StephenArwine/SaLElectronics/hw/SaL_Frostburn-v1.1/pdf's/SaLFrostburnbrd.pdf

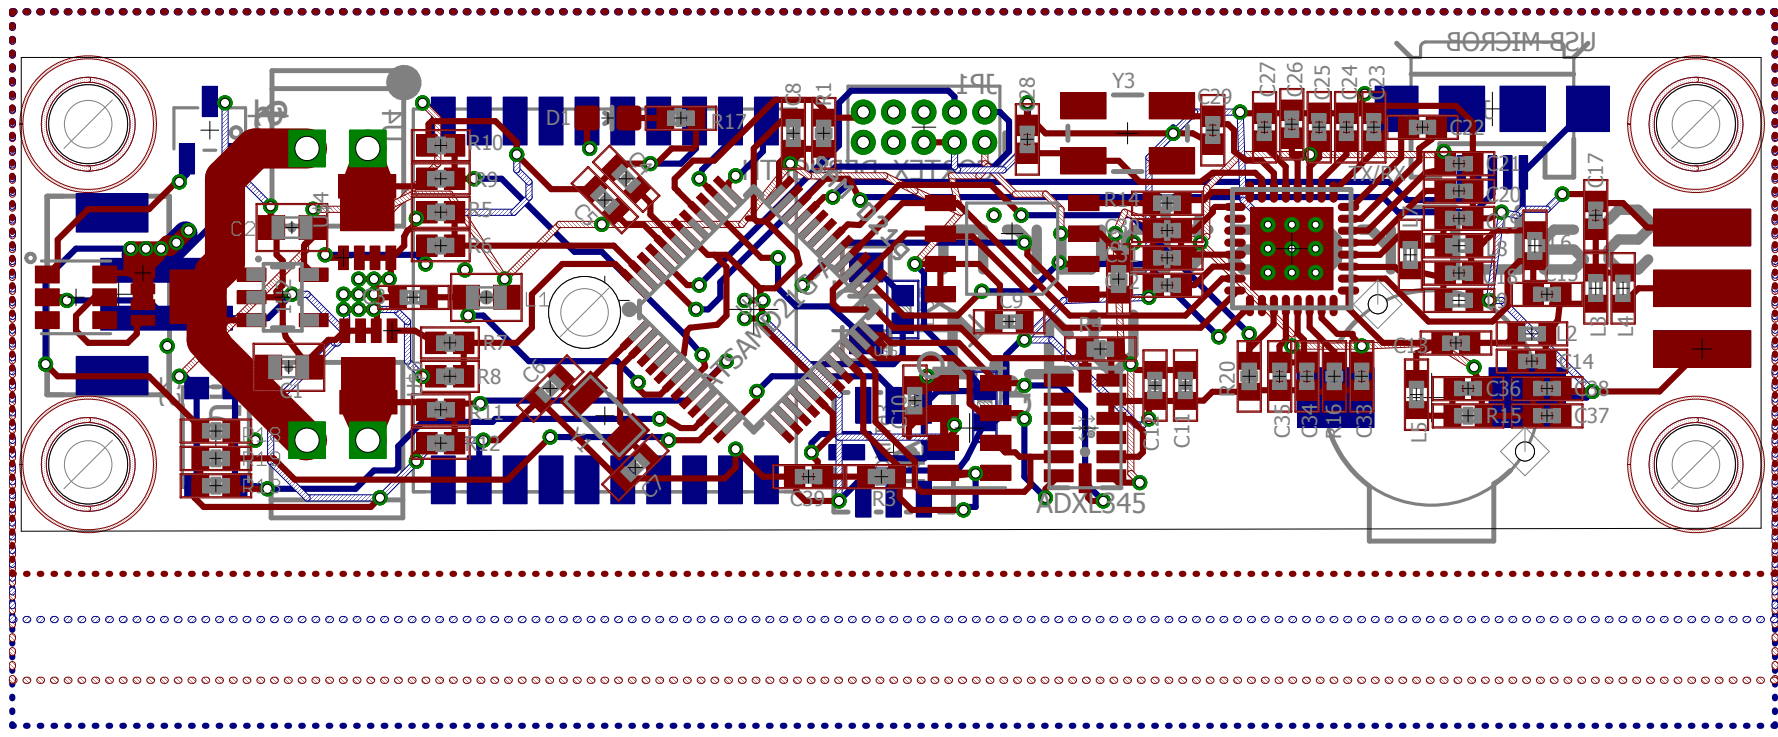
[picture p3: page 1]
