StephenArwine/SaLElectronics/hw/SaL_GPSTrack/SaL_GPSTrack.brd

## EAGLE design hw/SaL_GPSTrack/SaL_GPSTrack.brd (2017-10-22)

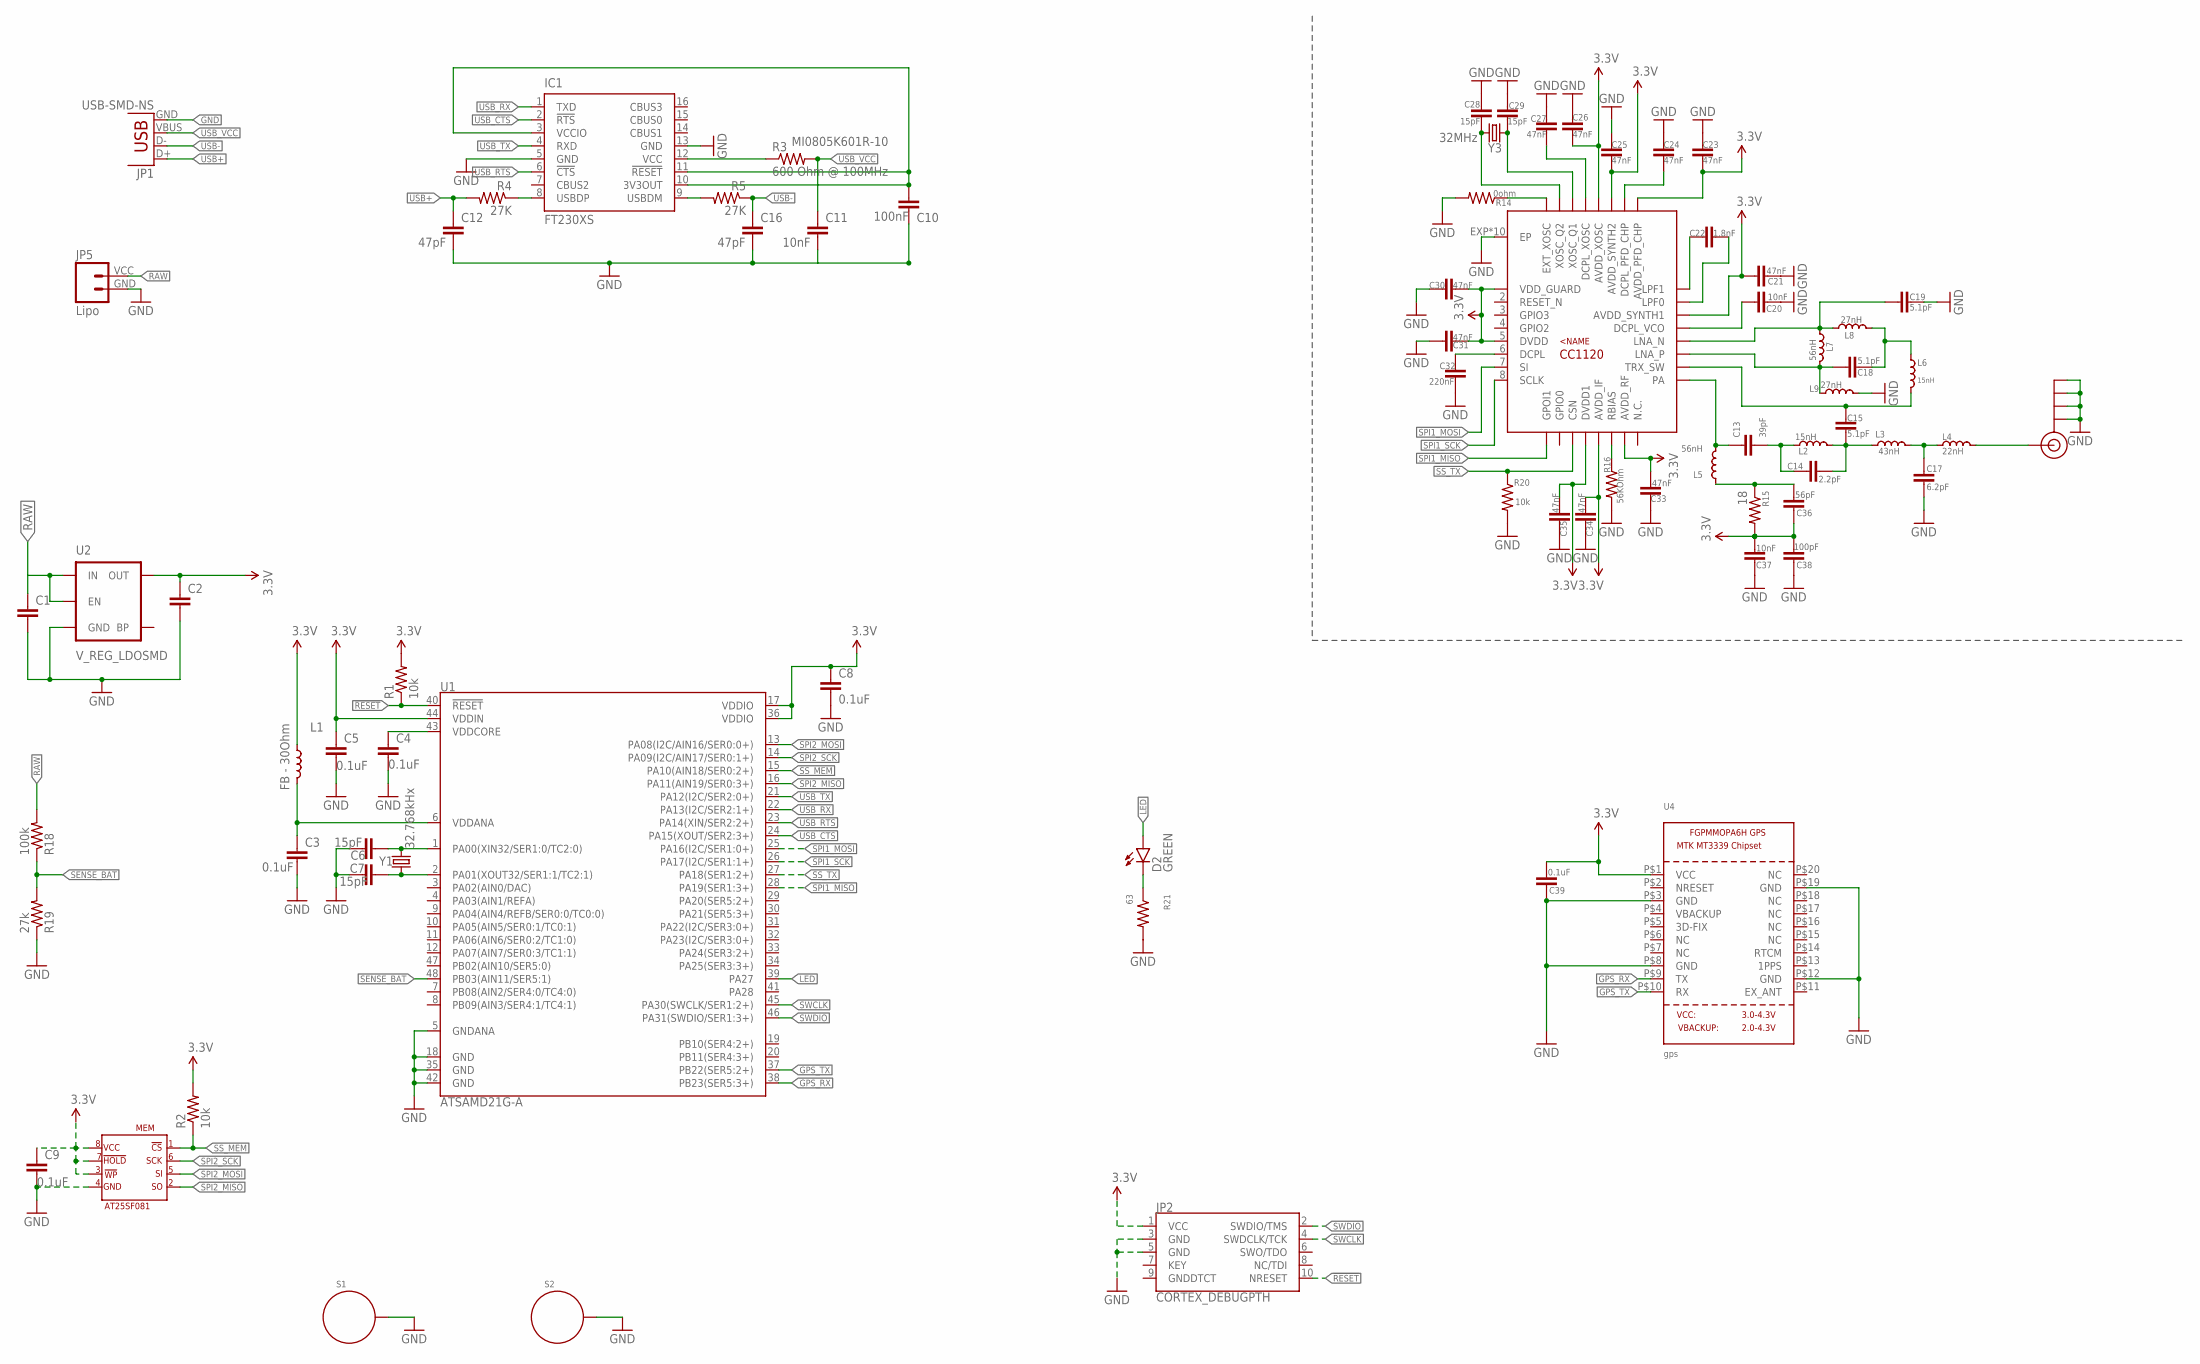
[picture p4: schematic SaL_GPSTrack.sch]

Parts:
C1, C2: CAP0603-CAP; 0603-CAP
C3, C4, C5, C8, C9, C39: 0.1uF; 0402-CAP
C6, C7, C28, C29: 15pF; 0402-CAP
C10: 100nF; 0402-CAP
C11, C20, C37: 10nF; 0402-CAP
C12, C16: 47pF; 0402-CAP
C13: 39pF; 0402-CAP
C14: 2.2pF; 0402-CAP
C15, C18, C19: 5.1pF; 0402-CAP
C17: 6.2pF; 0402-CAP
C21, C23, C24, C25, C26, C27, C30, C31, C33, C34, C35: 47nF; 0402-CAP
C22: 1.8nF; 0402-CAP
C32: 220nF; 0402-CAP
C36: 56pF; 0402-CAP
C38: 100pF; 0402-CAP
D2: GREEN; LED-1206
IC1: FT230XS; SSOP16
J$1: SMA_EDGE; SMA-EDGE
JP1: USB-SMD-NS; USB-MINIB-NOSTOP
JP2: CORTEX_DEBUGPTH; 2X5-PTH-1.27MM
JP5: Lipo; JST-2-SMD-VERT
L1: FB - 30Ohm; 0603
L2, L6: 15nH; C0402
L3: 43nH; C0402
L4: 22nH; C0402
L5, L7: 56nH; C0402
L8, L9: 27nH; C0402
MEM: AT25SF081
R1, R2, R20: 10k; 0402-RES
R3: 600 Ohm @ 100MHz; 0603-RES
R4, R5: 27K; 0402-RES
R14: 0ohm; 0402-RES
R15: 18; 0402-RES
R16: 56KOhm; 0402-RES
R18: 100k; 0402-RES
R19: 27k; 0402-RES
R21: 63; 0402-RES
S1, S2: STANDOFF_ELECTRICAL; STANDOFF-ELECTRICAL
TX/RX: CC1120
U1: ATSAMD21G-A; TQFP-48
U2: V_REG_LDOSMD; SOT23-5
U4: gps; FGPMMOPA6H
Y1: 32.768kHx; CRYSTAL-SMD-3.2X1.5MM
Y3: 32MHz; CRYSTAL-SMD-5X3

Connections:
!RESET: JP2.10 (NRESET), R1.1, U1.40 (!RESET!)
+3.3V: C2.1, C5.1, C8.1, C9.1, C21.1, C23.2, C25.2, C26.2, C30.2, C31.2, C33.2, C34.2, C35.2, C36.1, C37.2, C38.2, C39.2, JP2.1 (VCC), L1.1, MEM.!HOLD, MEM.!WP, MEM.VCC, R1.2, R2.2, R15.2, TX/RX.1 (VDD_GUARD), TX/RX.5 (DVDD), TX/RX.12 (DVDD1), TX/RX.13 (AVDD_IF), TX/RX.15 (AVDD_RF), TX/RX.22 (AVDD_SYNTH1), TX/RX.25 (AVDD_PFD_CHP), TX/RX.27 (AVDD_SYNTH2), TX/RX.28 (AVDD_XOSC), U1.17 (VDDIO), U1.36 (VDDIO), U1.44 (VDDIN), U2.5 (OUT), U4.P$1 (VCC)
GND: C1.2, C2.2, C3.2, C4.2, C5.2, C6.2, C7.2, C8.2, C9.2, C10.2, C11.2, C12.2, C16.2, C17.2, C19.2, C20.2, C21.2, C23.1, C24.1, C25.1, C26.1, C27.1, C28.1, C29.1, C30.1, C31.1, C32.1, C33.1, C34.1, C35.1, C37.1, C38.1, C39.1, IC1.5 (GND), IC1.13 (GND), J$1.GND@0 (GND), J$1.GND@1 (GND), J$1.GND@2 (GND), J$1.GND@3 (GND), JP1.GND, JP2.3 (GND), JP2.5 (GND), JP5.GND (1), L9.2, MEM.GND, R14.2, R16.2, R19.1, R20.2, R21.2, S1.P1, S2.P1, TX/RX.EXP (EP), TX/RX.EXP@1 (EP), TX/RX.EXP@2 (EP), TX/RX.EXP@3 (EP), TX/RX.EXP@4 (EP), TX/RX.EXP@5 (EP), TX/RX.EXP@6 (EP), TX/RX.EXP@7 (EP), TX/RX.EXP@8 (EP), TX/RX.EXP@9 (EP), U1.5 (GNDANA), U1.18 (GND), U1.35 (GND), U1.42 (GND), U2.2 (GND), U4.P$3 (GND), U4.P$8 (GND), U4.P$12 (GND), U4.P$19 (GND)
GPS_RX: U1.38 (PB23(SER5:3+)), U4.P$9 (TX)
GPS_TX: U1.37 (PB22(SER5:2+)), U4.P$10 (RX)
LED: D2.A, U1.39 (PA27)
unnamed: IC1.12 (VCC), R3.1
unnamed: C6.1, U1.1 (PA00(XIN32/SER1:0/TC2:0)), Y1.P$2 (2)
unnamed: C7.1, U1.2 (PA01(XOUT32/SER1:1/TC2:1)), Y1.P$1 (1)
unnamed: C3.1, L1.2, U1.6 (VDDANA)
unnamed: C4.1, U1.43 (VDDCORE)
unnamed: C10.1, IC1.3 (VCCIO), IC1.10 (3V3OUT), IC1.11 (!RESET)
unnamed: IC1.8 (USBDP), R4.1
unnamed: C13.1, L5.2, TX/RX.17 (PA)
unnamed: C13.2, C14.1, L2.1
unnamed: C14.2, C15.1, L2.2, L3.1
unnamed: C17.1, L3.2, L4.1
unnamed: J$1.SIG (SIGNAL), L4.2
unnamed: IC1.9 (USBDM), R5.2
unnamed: C15.2, L6.2, TX/RX.18 (TRX_SW)
unnamed: C18.1, L7.2, L9.1, TX/RX.19 (LNA_P)
unnamed: C18.2, L6.1, L8.2
unnamed: C19.1, L7.1, L8.1, TX/RX.20 (LNA_N)
unnamed: C22.1, TX/RX.24 (LPF1)
unnamed: C22.2, TX/RX.23 (LPF0)
unnamed: C20.1, TX/RX.21 (DCPL_VCO)
unnamed: C24.2, TX/RX.26 (DCPL_PFD_CHP)
unnamed: R16.1, TX/RX.14 (RBIAS)
unnamed: R14.1, TX/RX.32 (EXT_XOSC)
unnamed: C27.2, TX/RX.29 (DCPL_XOSC)
unnamed: C29.2, TX/RX.30 (XOSC_Q1), Y3.3 (2)
unnamed: C28.2, TX/RX.31 (XOSC_Q2), Y3.1
unnamed: D2.C, R21.1
unnamed: C32.2, TX/RX.6 (DCPL)
unnamed: C36.2, L5.1, R15.1
RAW: C1.1, JP5.VCC (2), R18.2, U2.1 (IN), U2.3 (EN)
SENSE_BAT: R18.1, R19.2, U1.48 (PB03(AIN11/SER5:1))
SPI1_MISO: TX/RX.9 (GPOI1), U1.28 (PA19(SER1:3+))
SPI1_MOSI: TX/RX.7 (SI), U1.25 (PA16(I2C/SER1:0+))
SPI1_SCK: TX/RX.8 (SCLK), U1.26 (PA17(I2C/SER1:1+))
SPI2_MISO: MEM.SO, U1.16 (PA11(AIN19/SER0:3+))
SPI2_MOSI: MEM.SI, U1.13 (PA08(I2C/AIN16/SER0:0+))
SPI2_SCK: MEM.SCK, U1.14 (PA09(I2C/AIN17/SER0:1+))
SS_MEM: MEM.!CS, R2.1, U1.15 (PA10(AIN18/SER0:2+))
SS_TX: R20.1, TX/RX.11 (CSN), U1.27 (PA18(SER1:2+))
SWCLK: JP2.4 (SWDCLK/TCK), U1.45 (PA30(SWCLK/SER1:2+))
SWDIO: JP2.2 (SWDIO/TMS), U1.46 (PA31(SWDIO/SER1:3+))
USB+: C12.1, JP1.D+, R4.2
USB-: C16.1, JP1.D-, R5.1
USB_CTS: IC1.2 (!RTS), U1.24 (PA15(XOUT/SER2:3+))
USB_RTS: IC1.6 (!CTS), U1.23 (PA14(XIN/SER2:2+))
USB_RX: IC1.1 (TXD), U1.22 (PA13(I2C/SER2:1+))
USB_TX: IC1.4 (RXD), U1.21 (PA12(I2C/SER2:0+))
USB_VCC: C11.1, JP1.VBUS, R3.2

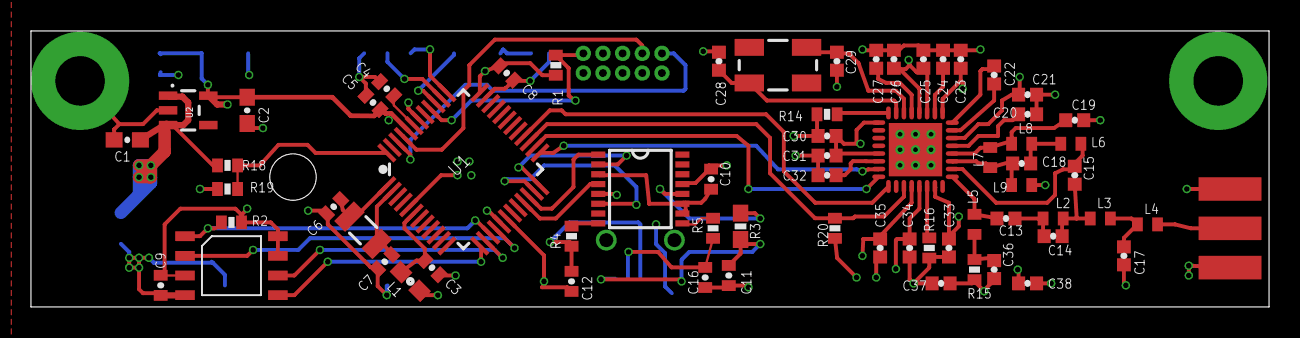
[picture p5: board SaL_GPSTrack.brd from above]

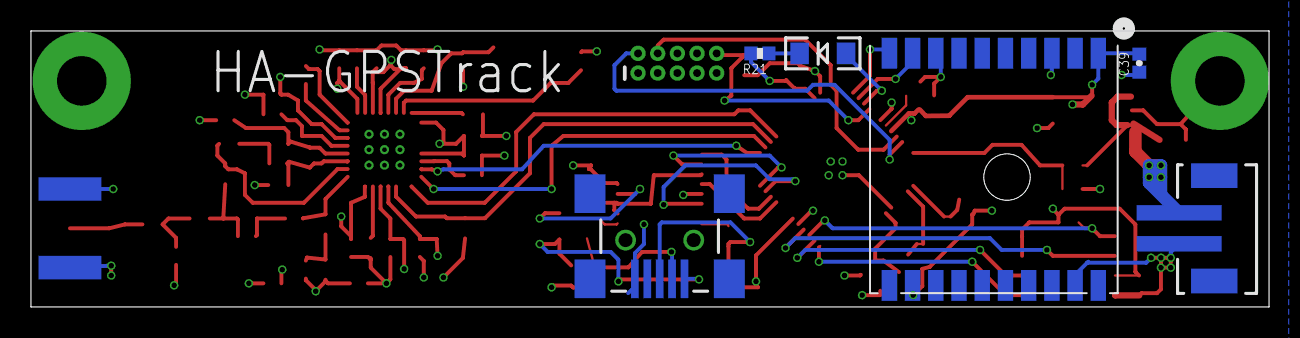
[picture p6: board SaL_GPSTrack.brd from below]

Board: 4 copper layers, 80.0 x 17.8 mm, 75 parts (7 on the bottom side), 54 nets.
