StephenArwine/SaLElectronics/hw/SaLAltimeter/SaLAltimeter.brd

## EAGLE design hw/SaLAltimeter/SaLAltimeter.brd (2016-01-22)

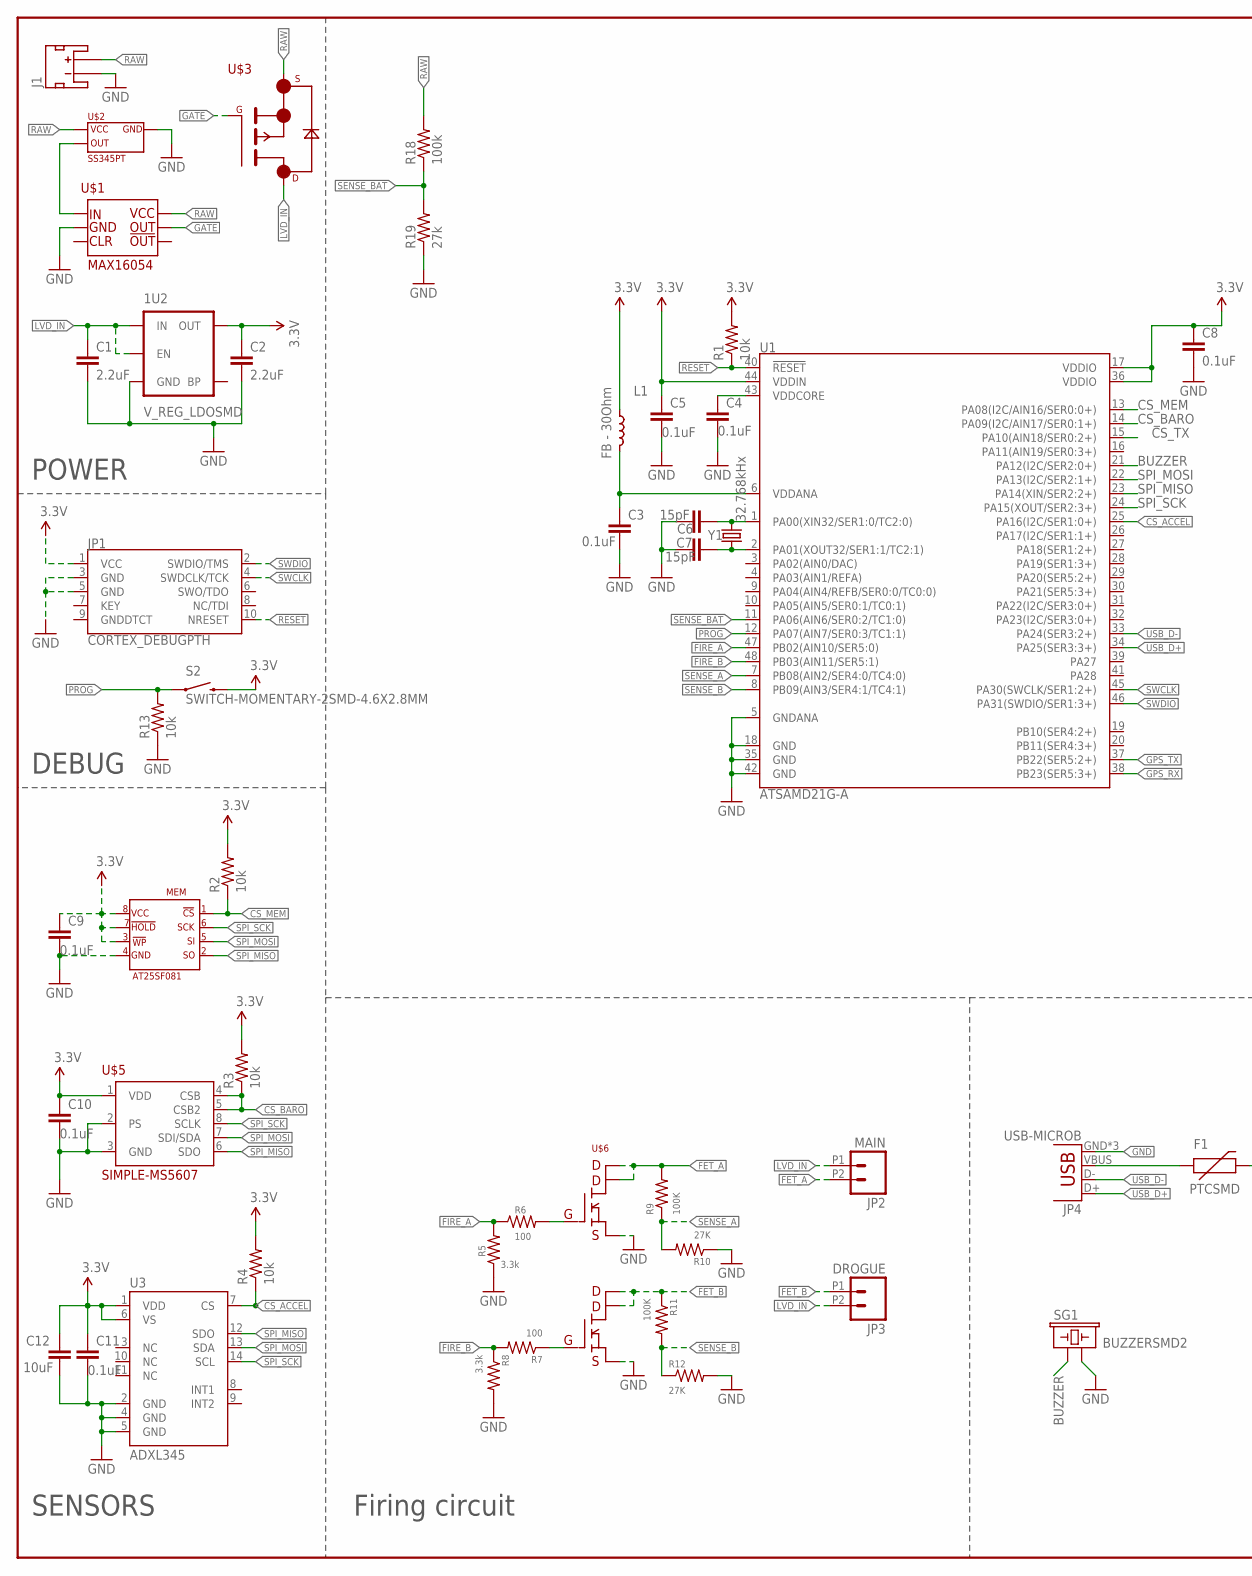
[picture p7: schematic SaLAltimeter.sch, part in row 1, column 1]

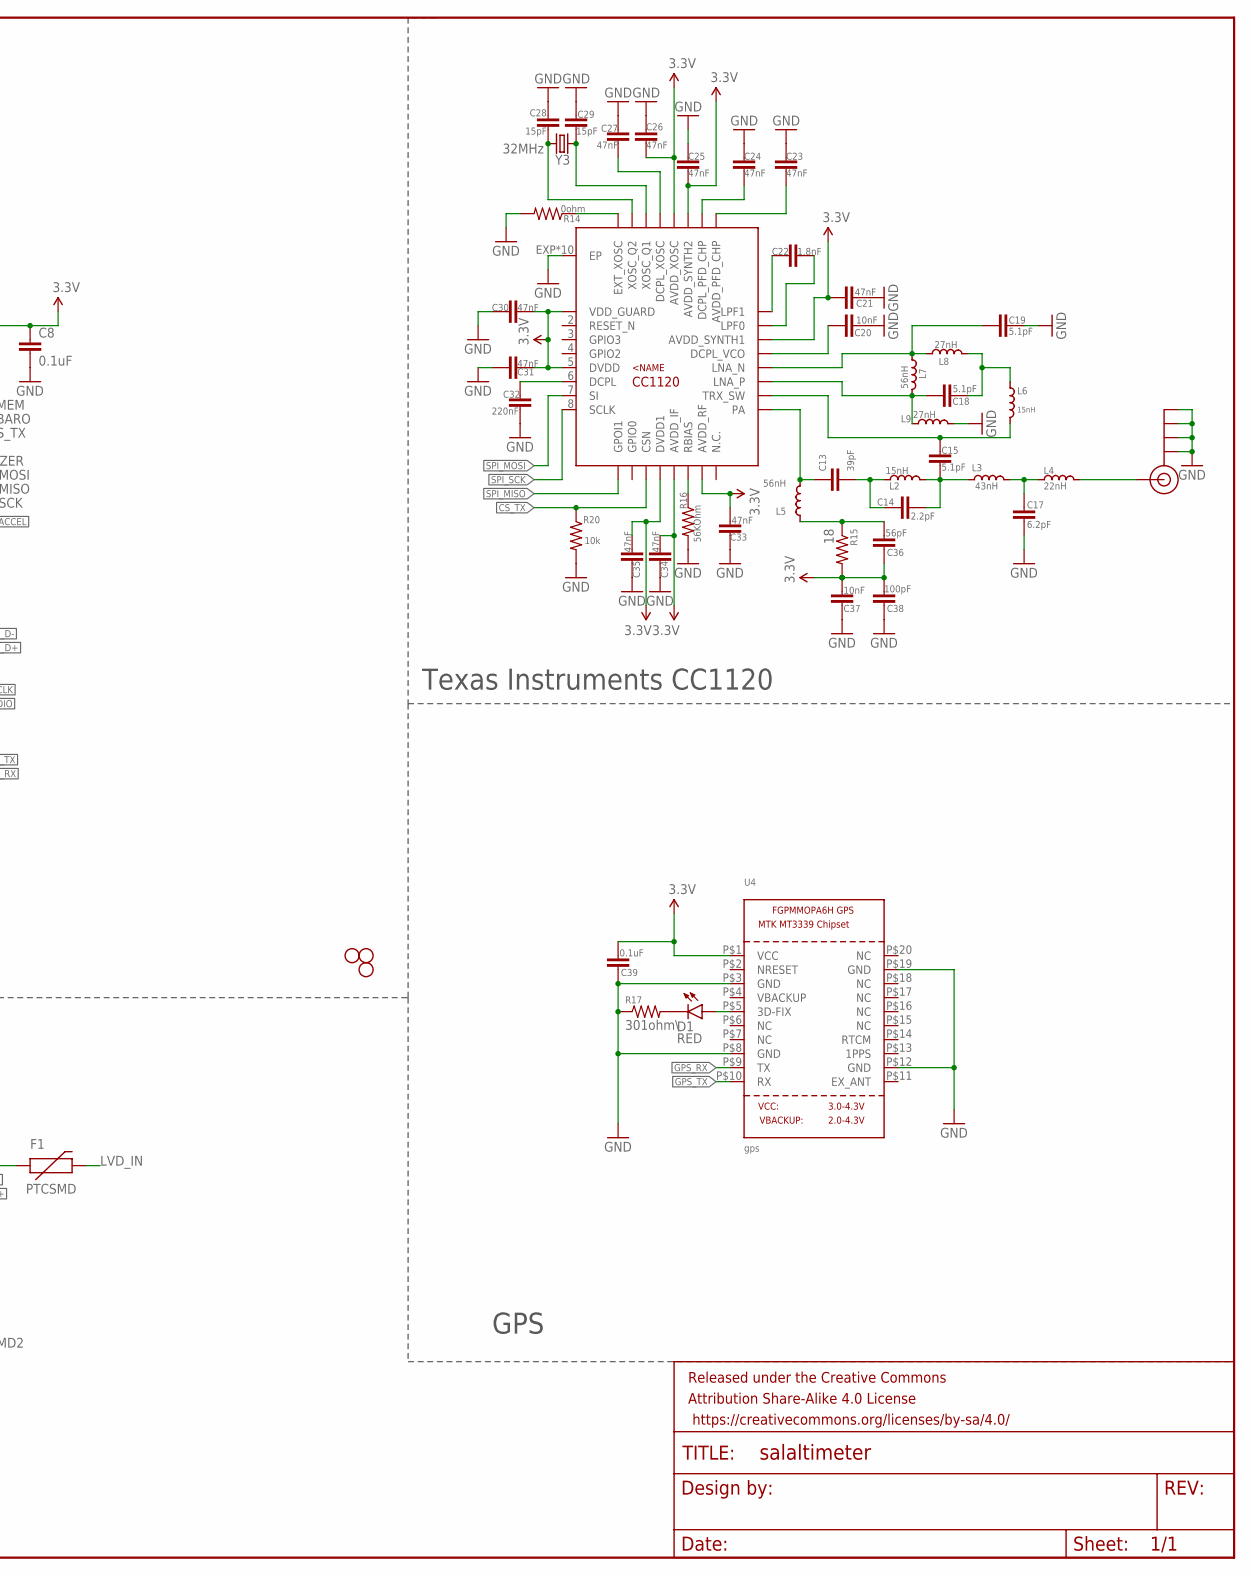
[picture p8: schematic SaLAltimeter.sch, part in row 1, column 2]

Parts:
1U2: V_REG_LDOSMD; SOT23-5
C1, C2: 2.2uF; 0603-CAP
C3, C4, C5, C8, C9, C10, C11, C39: 0.1uF; 0402-CAP
C6, C7, C28, C29: 15pF; 0402-CAP
C12: 10uF; 0402-CAP
C13: 39pF; 0402-CAP
C14: 2.2pF; 0402-CAP
C15, C18, C19: 5.1pF; 0402-CAP
C17: 6.2pF; 0402-CAP
C20, C37: 10nF; 0402-CAP
C21, C23, C24, C25, C26, C27, C30, C31, C33, C34, C35: 47nF; 0402-CAP
C22: 1.8nF; 0402-CAP
C32: 220nF; 0402-CAP
C36: 56pF; 0402-CAP
C38: 100pF; 0402-CAP
D1: RED; LED-0603
F1: PTCSMD; PTC-1206
FRAME1: FRAME-LEDGER; CREATIVE_COMMONS
J1: BAT; JST-2-SMD
J$1: SMA_EDGE; SMA-EDGE
JP1: CORTEX_DEBUGPTH; 2X5-PTH-1.27MM
JP2: MAIN; 1X02_2.54_SCREWTERM
JP3: DROGUE; 1X02_2.54_SCREWTERM
JP4: USB-MICROB
L1: FB - 30Ohm; 0603
L2, L6: 15nH; C0402
L3: 43nH; C0402
L4: 22nH; C0402
L5, L7: 56nH; C0402
L8, L9: 27nH; C0402
MEM: AT25SF081
R1, R2, R3, R4, R13, R20: 10k; 0402-RES
R5, R8: 3.3k; 0402-RES
R6, R7: 100; 0402-RES
R9, R11: 100K; 0402-RES
R10, R12: 27K; 0402-RES
R14: 0ohm; 0402-RES
R15: 18; 0402-RES
R16: 56KOhm; 0402-RES
R17: 301ohm\; 0402-RES
R18: 100k; 0402-RES
R19: 27k; 0402-RES
S2: SWITCH-MOMENTARY-2SMD-4.6X2.8MM; TACTILE_SWITCH_SMD_4.6X2.8MM
SG1: BUZZERSMD2; BUZZER-CCV
STANDOFF1, STANDOFF2, STANDOFF3: STAND-OFF
U1: ATSAMD21G-A; TQFP-48
U2: CC1120
U3: ADXL345; LGA14
U4: gps; FGPMMOPA6H
U$1: MAX16054
U$2: SS345PT
U$3: SI7615ADN
U$5: SIMPLE-MS5607; MS5607
U$6: SI7232DN
Y1: 32.768kHx; CRYSTAL-SMD-3.2X1.5MM
Y3: 32MHz; CRYSTAL-SMD-5X3

Connections:
3.3V: 1U2.5 (OUT), C2.1, C5.1, C8.1, C9.1, C10.1, C11.1, C12.1, C21.1, C25.2, C26.2, C30.2, C31.2, C33.2, C34.2, C35.2, C36.1, C37.2, C38.2, C39.2, JP1.1 (VCC), L1.1, MEM.!HOLD, MEM.!WP, MEM.VCC, R1.2, R2.2, R3.2, R4.2, R15.2, S2.3 (2), S2.4 (2), U1.17 (VDDIO), U1.36 (VDDIO), U1.44 (VDDIN), U2.1 (VDD_GUARD), U2.5 (DVDD), U2.12 (DVDD1), U2.13 (AVDD_IF), U2.15 (AVDD_RF), U2.22 (AVDD_SYNTH1), U2.27 (AVDD_SYNTH2), U2.28 (AVDD_XOSC), U3.1 (VDD), U3.6 (VS), U4.P$1 (VCC), U$5.1 (VDD)
!RESET: JP1.10 (NRESET), R1.1, U1.40 (!RESET!)
BUZZER: SG1.+ (1), U1.21 (PA12(I2C/SER2:0+))
CS_ACCEL: R4.1, U1.25 (PA16(I2C/SER1:0+)), U3.7 (CS)
CS_BARO: R3.1, U1.14 (PA09(I2C/AIN17/SER0:1+)), U$5.4 (CSB), U$5.5 (CSB2)
CS_MEM: MEM.!CS, R2.1, U1.13 (PA08(I2C/AIN16/SER0:0+))
CS_TX: R20.1, U1.15 (PA10(AIN18/SER0:2+)), U2.11 (CSN)
FET_A: JP2.P2 (2), R9.2, U$6.7 (PIN7), U$6.8 (PIN8)
FET_B: JP3.P1 (1), R11.1, U$6.5 (PIN5), U$6.6 (PIN6)
FIRE_A: R5.2, R6.1, U1.47 (PB02(AIN10/SER5:0))
FIRE_B: R7.2, R8.1, U1.48 (PB03(AIN11/SER5:1))
GATE: U$1.OUT, U$3.G
GND: 1U2.2 (GND), C1.2, C2.2, C3.2, C4.2, C5.2, C6.2, C7.2, C8.2, C9.2, C10.2, C11.2, C12.2, C17.2, C19.2, C20.2, C21.2, C23.1, C24.1, C25.1, C26.1, C27.1, C28.1, C29.1, C30.1, C31.1, C32.1, C33.1, C34.1, C35.1, C37.1, C38.1, C39.1, J1.1 (-), J$1.GND@0 (GND), J$1.GND@1 (GND), J$1.GND@2 (GND), J$1.GND@3 (GND), JP1.3 (GND), JP1.5 (GND), JP4.GND, JP4.MT1 (GND), JP4.MT2 (GND), L9.2, MEM.GND, R5.1, R8.2, R10.1, R12.2, R13.1, R14.2, R16.2, R17.1, R19.1, R20.2, SG1.- (2), U1.5 (GNDANA), U1.18 (GND), U1.35 (GND), U1.42 (GND), U2.EXP (EP), U2.EXP@1 (EP), U2.EXP@2 (EP), U2.EXP@3 (EP), U2.EXP@4 (EP), U2.EXP@5 (EP), U2.EXP@6 (EP), U2.EXP@7 (EP), U2.EXP@8 (EP), U2.EXP@9 (EP), U3.2 (GND), U3.4 (GND), U3.5 (GND), U4.P$3 (GND), U4.P$8 (GND), U4.P$12 (GND), U4.P$19 (GND), U$1.GND, U$2.GND, U$5.2 (PS), U$5.3 (GND), U$6.1 (PIN1), U$6.3 (PIN3)
GPS_RX: U1.38 (PB23(SER5:3+)), U4.P$9 (TX)
GPS_TX: U1.37 (PB22(SER5:2+)), U4.P$10 (RX)
LVD_IN: 1U2.1 (IN), 1U2.3 (EN), C1.1, F1.2, JP2.P1 (1), JP3.P2 (2), U$3.D1 (D), U$3.D2 (D), U$3.D3 (D), U$3.D4 (D)
unnamed: R6.2, U$6.2 (PIN2)
unnamed: U$1.IN, U$2.OUT
unnamed: C6.1, U1.1 (PA00(XIN32/SER1:0/TC2:0)), Y1.P$2 (2)
unnamed: C7.1, U1.2 (PA01(XOUT32/SER1:1/TC2:1)), Y1.P$1 (1)
unnamed: C3.1, L1.2, U1.6 (VDDANA)
unnamed: C4.1, U1.43 (VDDCORE)
unnamed: R7.1, U$6.4 (PIN4)
unnamed: C13.1, L5.2, U2.17 (PA)
unnamed: C13.2, C14.1, L2.1
unnamed: C14.2, C15.1, L2.2, L3.1
unnamed: C17.1, L3.2, L4.1
unnamed: J$1.SIG (SIGNAL), L4.2
unnamed: F1.1, JP4.VBUS
unnamed: C23.2, U2.25 (AVDD_PFD_CHP)
unnamed: C15.2, L6.2, U2.18 (TRX_SW)
unnamed: C18.1, L7.2, L9.1, U2.19 (LNA_P)
unnamed: C18.2, L6.1, L8.2
unnamed: C19.1, L7.1, L8.1, U2.20 (LNA_N)
unnamed: C22.1, U2.24 (LPF1)
unnamed: C22.2, U2.23 (LPF0)
unnamed: C20.1, U2.21 (DCPL_VCO)
unnamed: C24.2, U2.26 (DCPL_PFD_CHP)
unnamed: R16.1, U2.14 (RBIAS)
unnamed: R14.1, U2.32 (EXT_XOSC)
unnamed: C27.2, U2.29 (DCPL_XOSC)
unnamed: C29.2, U2.30 (XOSC_Q1), Y3.3 (2)
unnamed: C28.2, U2.31 (XOSC_Q2), Y3.1
unnamed: D1.C, R17.2
unnamed: D1.A, U4.P$5 (3D-FIX)
unnamed: C32.2, U2.6 (DCPL)
unnamed: C36.2, L5.1, R15.1
PROG: R13.2, S2.1, S2.2 (1), U1.12 (PA07(AIN7/SER0:3/TC1:1))
RAW: J1.2 (+), R18.2, U$1.VCC, U$2.VCC, U$3.S1 (S), U$3.S2 (S), U$3.S3 (S)
SENSE_A: R9.1, R10.2, U1.7 (PB08(AIN2/SER4:0/TC4:0))
SENSE_B: R11.2, R12.1, U1.8 (PB09(AIN3/SER4:1/TC4:1))
SENSE_BAT: R18.1, R19.2, U1.11 (PA06(AIN6/SER0:2/TC1:0))
SPI_MISO: MEM.SO, U1.23 (PA14(XIN/SER2:2+)), U2.9 (GPOI1), U3.12 (SDO), U$5.6 (SDO)
SPI_MOSI: MEM.SI, U1.22 (PA13(I2C/SER2:1+)), U2.7 (SI), U3.13 (SDA), U$5.7 (SDI/SDA)
SPI_SCK: MEM.SCK, U1.24 (PA15(XOUT/SER2:3+)), U2.8 (SCLK), U3.14 (SCL), U$5.8 (SCLK)
SWCLK: JP1.4 (SWDCLK/TCK), U1.45 (PA30(SWCLK/SER1:2+))
SWDIO: JP1.2 (SWDIO/TMS), U1.46 (PA31(SWDIO/SER1:3+))
USB_D+: JP4.D+, U1.34 (PA25(SER3:3+))
USB_D-: JP4.D-, U1.33 (PA24(SER3:2+))

Notes on the sheet:
POWER
DEBUG
SENSORS
Texas Instruments CC1120
Firing circuit
GPS

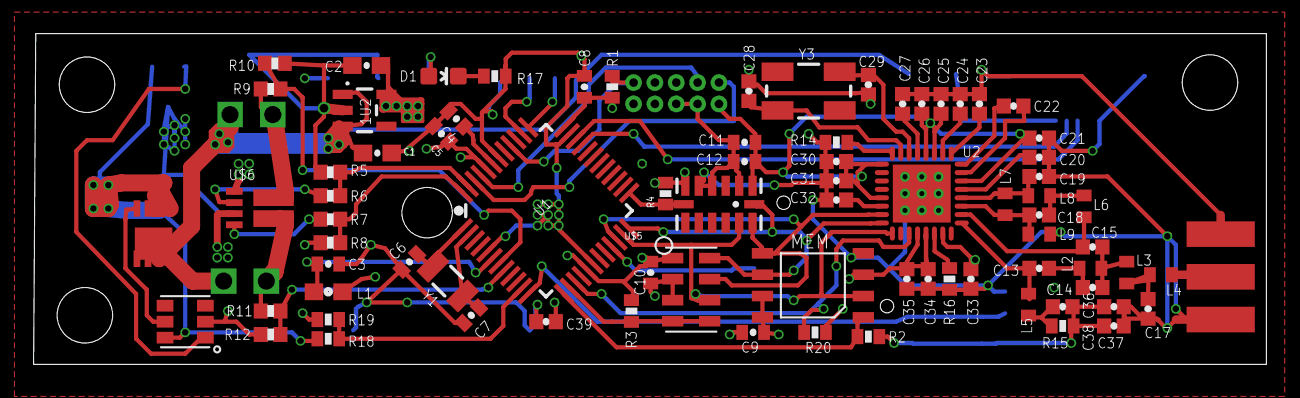
[picture p9: board SaLAltimeter.brd from above]

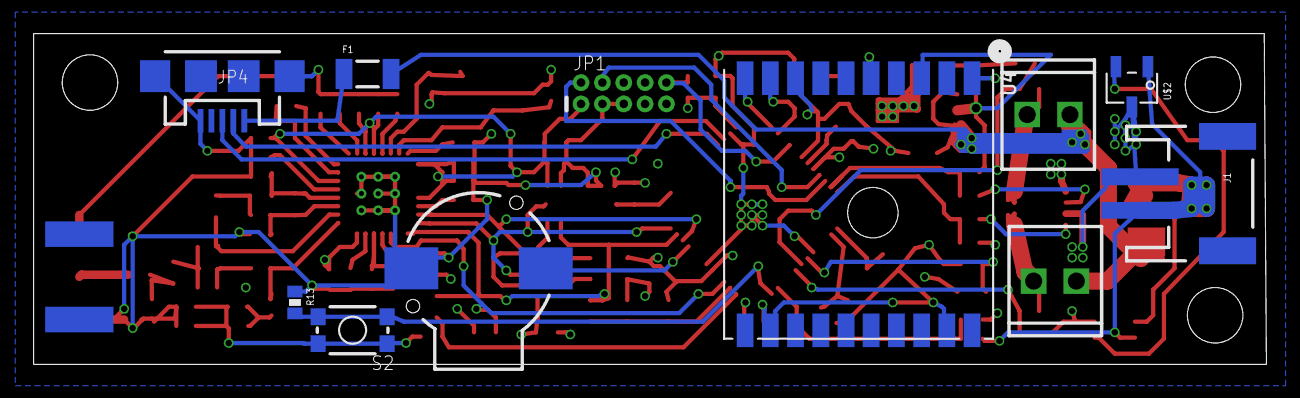
[picture p10: board SaLAltimeter.brd from below]

Board: 4 copper layers, 73.3 x 19.7 mm, 94 parts (11 on the bottom side), 59 nets.
