StephenArwine/SaLElectronics/src/services/SaL_flight.c

#include "SaL_flight.h"



void Sal_flight() {


    while (true) {

        switch (SaL_flight_state) {
        case SaL_flight_startup:
		
            break;

        case SaL_flight_pad:
		
            break;

        case  SaL_flight_boost:
		
            break;

        case SaL_flight_coast:
		
            break;

        case SaL_flight_drogue:
		
            break;

        case SaL_flight_main:
		
            break;

        case SaL_flight_landed:
		
            break;

        case  SaL_flight_error:
		
            break;

        case SaL_flight_program:
		
            break;

        default:
		
            break;
        }

    }

}

void SaL_flight_init() {

}
