StephenArwine/SaLElectronics/src/services/SaLTypes.h

#define ATOMIC_SECTION_ENTER   { register uint32_t __atomic; \
	__asm volatile ("mrs %0, primask" : "=r" (__atomic) ); \
	__asm volatile ("cpsid i");
#define ATOMIC_SECTION_LEAVE   __asm volatile ("msr primask, %0" : : "r" (__atomic) ); }

#include <stddef.h>
#include <stdint.h>
#include <stdio.h>
#include <stdlib.h>
#include <stdbool.h>
#include <string.h>
#include <compiler.h>
