StephenArwine/SaLElectronics/src/services/SaLSpi.h

#ifndef SALSPI_H_
#define SALSPI_H_

#include <SaL.h>
 
//   struct spiModule{
// 
//     uint8_t MISO;
// 
//     uint8_t MOSI;
// 
//     uint8_t SCK;
// 
//     uint8_t SS;
// 
//     uint8_t BYTEOUT;
// 
//     uint8_t BYTEIN;
// 
// #define PINHIGH true
// #define PINLOW false
// 
// };

//  void configSpiModule(struct spiModule *const module,
//                                    uint8_t MOSI_PIN,
//                                    uint8_t MISO_pin,
//                                    uint8_t SCK_PIN,
//                                    uint8_t SS_PIN );


#endif
