StephenArwine/SaLElectronics/(commit log)

2016-01-19 working on accelerometer crap
2016-01-20 finally fixed clocks and got others working woohoo
    [ADXL345.c, ADXL345.h, SaLBitBang.c, SaLBitBang.h, SaLBuzzer.c, SaLBuzzer.h, SaLDelay.c]
2016-01-22 got accelerometer working and working on v1.5 in eagle
    [SaLAltimeter 1.5.brd, SaLAltimeter 1.5.sch, SaLAltimeter.brd, SaLAltimeter.sch, partslist final.xlsx, partslist.xlsx, partslist2.xlsx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]
2016-01-23 fixed acceleration and bit banging using defines instead of spimodule struct
    [ADXL345.c, ADXL345.h, MS5607.c, MS5607.h, SaLAccelerometer.c, SaLAccelerometer.h, SaLBitBang.c, SaLBitBang.h]
2016-01-24 fixed types and working on timer stuff
    [MS5607.c, MS5607.h, SaLAccelerometer.c, SaLAccelerometer.h, SaLAltimeter.h, SaLBarometer.c]
2016-01-30 GPS is correctly parsing the time and position!
    [MTK3329.c, MTK3329.h, SaLBarometer.c, SaLUSART.c, SaLUSART.h, boardDefines.h]
2016-01-31 fixed object orrentatedsensors and created sample
    [ADXL345.c, ADXL345.h, MS5607.c, MS5607.h, MTK3329.c, MTK3329.h, SaLAccelerometer.c]
2016-01-31 ground height prototype
2016-02-01 timer control up and running!
2016-02-01 15hz sample timer set up
2016-02-02 developed proper sampling algorithm, now samples at 1kHz when it was 300hz
2016-02-03 attempting to start filter stuff
2016-02-14 fixed some nested includes
    [ADXL345.c, ADXL345.h, AT25SF.c, AT25SF.h, MS5607.h, SaLAccelerometer.c, SaLBarometer.h]
2016-02-14 minor changes to HW
    [SaLAltimeter 1.5.brd, SaLAltimeter 1.5.sch, SaLFrostburn.brd, SaLFrostburn.sch]
2016-02-14 minor hardware changes, added led and analog accel
    [SaLFrostburn.sch]
2016-02-16 SaLFrostburn-v1.1 hw finished and ordered
    [SaLFrostburn.brd, SaLFrostburn.sch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]
2016-02-17 small changes to usb drivers
    [SaLFrostburn.sch]
2016-02-18 battery sensing done
2016-02-20 working on non blocking buzzer code
    [SaLBuzzer.c, SaLBuzzer.h, SaLClocks.c, SaLPort.h, boardDefines.h]
2016-02-22 first pass at frostburn 1.2
    [SaLFrostburn.brd, SaLFrostburn.sch, SaLFrostburn1.2.brd, SaLFrostburn1.2.sch, partslist final.xlsx, partslist.xlsx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]
2016-02-28 small changes to buzzer
    [SaLBuzzer.c, SaLBuzzer.h, main.c]
2016-03-01 made sampleTick a boolean function
2016-03-14 added buzzer to 1.2 hw and setup 1.1 in studio
    [SaLFrostburn1.2.brd, SaLFrostburn1.2.sch]
2016-03-14 setting up 1.1, sensors not working atm
    [SaLAltimeter-1_0.c, SaLFrostburn1_1.c, boardDefines.h]
2016-03-14 troubleshooting baro, still not working
    [SaLFrostburn1_1.c]
2016-03-20 1.2 hw sent to fab and some work on 1.1 code
    [SaLFrostburn1.2.brd, SaLFrostburn1.2.sch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]
2016-03-27 analog accelerometer up and running, 0g offset needs some work
2017-09-01 maybe i fixed things? USART working, parsing not.,
    [SaL_GPSTrack.brd, SaL_GPSTrack.sch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]
2017-10-03 not real changes
    [SaLFrostburn1.2.brd, SaLFrostburn1.2.sch]
